PoliTeK/TS741/README.md

<h1 align="center">
	<br>
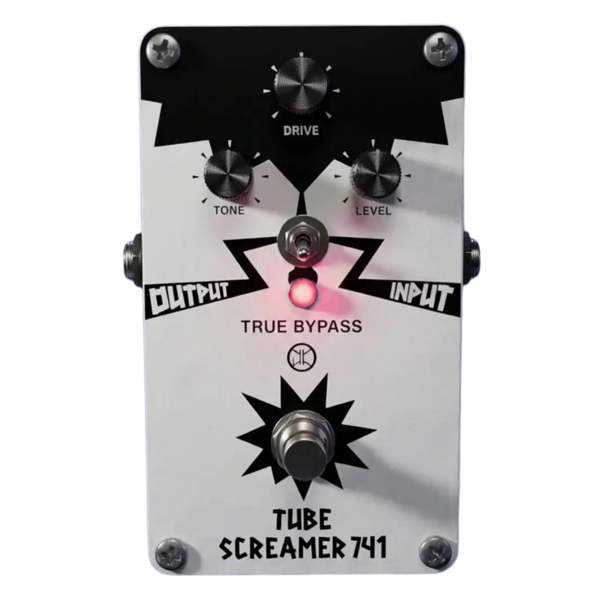
[picture p1: Images/TS741.webp]
		
	<br>
		TS741
	<br>
</h1>

<h4 align="center">A PoliTeK reproduction of the <a href="https://www.ibanez.com/eu/products/detail/ts9_99.html">Ibanez TS9</a>.</h4>

---

> ### 🎉 Big News!
> This project is now fully published! Check out the [Documentation folder](./Documents) for the datasheet, manual and technical documentation.

---

<p align="center">
	<a href="#key-features">Key Features</a> •
	<a href="#list-of-components">List of Components</a> •
	<a href="#how-to-use">How To Use</a> •
	<a href="#credits">Credits</a> •
	<a href="#license">License</a>
</p>

## Key Features

- **2 different clipping modes** using different diodes.
- **More bass mod**: boosted low frequences under 700Hz.
- **Tone mod**: wider frequency response, making the pedal more versatile for other instruments like synths.
- **9V Battery slot**, automatically unplugged when using cable power.
- **True Bypass** to deflect the signal directly from input to output when the effect is disabled.

## List of Components

### Resistors

| Resistor | Characteristics | Link |
| --- | --- | --- |
| $R1$ | $1\ k\Omega$ | [Mouser](https://www.mouser.it/ProductDetail/YAGEO/MFR-25FBF52-1k?qs=oAGoVhmvjhwCAC47ReWjsQ%3D%3D) |
| $R2$ | $510\ k\Omega$ | [Mouser](https://www.mouser.it/ProductDetail/YAGEO/MFR-25FBF52-510k?qs=oAGoVhmvjhztnZ0uHzkmNA%3D%3D) |
| $R3$ | $10\ k\Omega$ | [Mouser](https://www.mouser.it/ProductDetail/YAGEO/MFR-25FBF52-10k?qs=oAGoVhmvjhxY0mVN9GL5Pg%3D%3D) |
| $R4$ | $10\ k\Omega$ | [Mouser](https://www.mouser.it/ProductDetail/YAGEO/MFR-25FBF52-10k?qs=oAGoVhmvjhxY0mVN9GL5Pg%3D%3D) |
| $R5$ | $51\ k\Omega$<br>$100\ k\Omega$ | [Mouser](https://www.mouser.it/ProductDetail/YAGEO/MFR-25FTE52-51k?qs=UFD7vfw3J8rfrZHNaVfLZQ%3D%3D)<br>[Mouser](https://www.mouser.it/ProductDetail/YAGEO/MFR-25FTE52-100k?qs=oAGoVhmvjhwR6%252B9HMeoFJQ%3D%3D) |
| $R6$ | $4.7\ k\Omega$ | [Mouser](https://www.mouser.it/ProductDetail/YAGEO/MFR-12FTF52-4k7?qs=oAGoVhmvjhwCB3QIStJPAg%3D%3D) |
| $R7$ | $1\ k\Omega$ | [Mouser](https://www.mouser.it/ProductDetail/YAGEO/MFR-25FBF52-1k?qs=oAGoVhmvjhwCAC47ReWjsQ%3D%3D) |
| $R8$ | $10\ k\Omega$ | [Mouser](https://www.mouser.it/ProductDetail/YAGEO/MFR-25FBF52-10k?qs=oAGoVhmvjhxY0mVN9GL5Pg%3D%3D) |
| $R9$ | $1\ k\Omega$ | [Mouser](https://www.mouser.it/ProductDetail/YAGEO/MFR-25FBF52-1k?qs=oAGoVhmvjhwCAC47ReWjsQ%3D%3D) |
| $R10$ | $220\ \Omega$<br>$100\ \Omega$  | [Mouser](https://www.mouser.it/ProductDetail/YAGEO/MFR-25FTE52-220R?qs=oAGoVhmvjhzQYrU74Ttjlg%3D%3D)<br>[Mouser](https://www.mouser.it/ProductDetail/YAGEO/MFR-12FTE52-100R?qs=LqRJI78XBD5hLi4WOGMVUQ%3D%3D) |
| $R11$ | $1\ k\Omega$ | [Mouser](https://www.mouser.it/ProductDetail/YAGEO/MFR-25FBF52-1k?qs=oAGoVhmvjhwCAC47ReWjsQ%3D%3D) |
| $R12$ | $510\ k\Omega$ | [Mouser](https://www.mouser.it/ProductDetail/YAGEO/MFR-25FBF52-510k?qs=oAGoVhmvjhztnZ0uHzkmNA%3D%3D) |
| $R13$ | $10\ k\Omega$ | [Mouser](https://www.mouser.it/ProductDetail/YAGEO/MFR-25FBF52-10k?qs=oAGoVhmvjhxY0mVN9GL5Pg%3D%3D) |
| $R14$ | $100\ \Omega$ | [Mouser](https://www.mouser.it/ProductDetail/YAGEO/MFR-12FTE52-100R?qs=LqRJI78XBD5hLi4WOGMVUQ%3D%3D) |
| $R15$ | $10\ k\Omega$ | [Mouser](https://www.mouser.it/ProductDetail/YAGEO/MFR-25FBF52-10k?qs=oAGoVhmvjhxY0mVN9GL5Pg%3D%3D) |
| $R$ | $10\ k\Omega$ | [Mouser](https://www.mouser.it/ProductDetail/YAGEO/MFR-25FBF52-10k?qs=oAGoVhmvjhxY0mVN9GL5Pg%3D%3D) |

### Capacitors

| Capacitor | Characteristics | Link |
| --- | --- | --- |
| $C1$ | $0.02\mu F$ ceramic | [Mouser](https://www.mouser.it/ProductDetail/Vishay-BC-Components/S203M75Z5UN63J0R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) |
| $C2$ | $1\mu F/50V$ film | [Mouser](https://www.mouser.it/ProductDetail/kEMET/R82CC4100AA60J?qs=sGAEpiMZZMsh%252B1woXyUXjwYbDi8EMxhfWJiXWIjZ2PU%3D) |
| $C3$ | $51pF$ MLCC | [Mouser](https://www.mouser.it/ProductDetail/kYOCERA-AVX/SR212A510JARTR1?qs=jADPUJwhBMJOmYc%2FmUo3IA%3D%3D) |
| $C4$ | $0.047\mu F$ ceramic<br>$0.068\mu F$ ceramic | [Mouser](https://www.mouser.it/ProductDetail/kEMET/C320C473k1R5TA?qs=c4UyoTs%2FLq3hm3XzMZbfrg%3D%3D)<br>[Mouser](https://www.mouser.it/ProductDetail/kEMET/C320C683J5R5TA?qs=sGAEpiMZZMsh%252B1woXyUXjwqri5M3Q9AZpanpycjLvCQ%3D) |
| $C5$ | $0.22\mu F/35V$ electrolytic (polarized) | [Digikey](https://www.digikey.it/it/products/detail/panasonic-electronic-components/EEA-GA1HR22/2504589) |
| $C6$ | $0.22\mu F$ electrolytic (polarized) | [Digikey](https://www.digikey.it/it/products/detail/panasonic-electronic-components/EEA-GA1HR22/2504589) |
| $C7$ | $1\mu F/50V$ film | [Mouser](https://www.mouser.it/ProductDetail/kEMET/R82CC4100AA60J?qs=sGAEpiMZZMsh%252B1woXyUXjwYbDi8EMxhfWJiXWIjZ2PU%3D) |
| $C8$ | $0.1\mu F$ ceramic | [Mouser](https://www.mouser.it/ProductDetail/Vishay-BC-Components/k104k15X7RF5TH5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) |
| $C9$ | $10\mu F/16V$ film | [Mouser](https://www.mouser.it/ProductDetail/kEMET/C430C106k3R5TA?qs=QTajy0ParP4Iyid6Jgh%2FcQ%3D%3D) |
| $C10$ | $100\mu F/10V$ electrolytic | [Mouser](https://www.mouser.it/ProductDetail/Vishay-BC-Components/MAL214231101E3?qs=Ep9Lwju7gVq%252BiOgwdeHCkg%3D%3D) |
| $C11$ | $47\mu F/10V$ electrolytic | [Mouser](https://www.mouser.it/ProductDetail/kEMET/ESH476M050AG3kA?qs=gt1LBUVyoHkBFAjlyc6dSw%3D%3D) |

### Diodes

| Diode | Characteristics | Part Number | Link |
| --- | --- | --- | --- |
| $D1$ | Silicon diode | `1N4148` | [Mouser](https://www.mouser.it/ProductDetail/onsemi-Fairchild/1N4148?qs=i4Fj9T%2FoRm8RMUhj5DeFQg%3D%3D) |
| $D2$ | Silicon diode | `1N4148` | [Mouser](https://www.mouser.it/ProductDetail/onsemi-Fairchild/1N4148?qs=i4Fj9T%2FoRm8RMUhj5DeFQg%3D%3D) |
| $D3$<br>$D4$ | Silicon diode<br>Germanium diode<br>LED<br>BJT | `1N4148`<br>`OA95`<br>-<br>- | [Mouser](https://www.mouser.it/ProductDetail/onsemi-Fairchild/1N4148?qs=i4Fj9T%2FoRm8RMUhj5DeFQg%3D%3D)<br>[Pinto Elettronica](https://www.pintoelettronica.com/diodi-ponti-diodo-germanio-oa95.1.0.16.gp.4502.uw)<br>[Mouser](https://www.mouser.it/ProductDetail/Vishay-Siliconix/TLHG6420-CSZ?qs=M%2FWrVUahkW%2Feu6sB%252BQbN0w%3D%3D)<br>[Mouser](https://www.mouser.it/ProductDetail/Rectron/PN2222A-B?qs=wmP56CznGQlBAFU%2Fw%252Bn5vQ%3D%3D) |
| $D$ | Silicon diode | `1N4004` | [Mouser](https://www.mouser.it/ProductDetail/Diotec-Semiconductor/1N4004?qs=OlC7AqGiEDk3eaZusDVIWQ%3D%3D) |

### OP Amp

| OP Amp | Part Number | Link |
| --- | --- | --- |
| $IC1$  | `TL072` | [Mouser](https://www.mouser.it/ProductDetail/Texas-Instruments/TL072CP?qs=5nGYs9Do7G3e6Tx9uHIgUA%3D%3D) |

### Transistors

| Transistor | Part Number | Link |
| --- | --- | --- |
| $Q1$ | `BC550` | [Mouser](https://www.mouser.it/ProductDetail/onsemi-Fairchild/BC550CTA?qs=ljbEvF4DwOM46%2Fg9NzWlqQ%3D%3D) |
| $Q2$ | `BC550` | [Mouser](https://www.mouser.it/ProductDetail/onsemi-Fairchild/BC550CTA?qs=ljbEvF4DwOM46%2Fg9NzWlqQ%3D%3D) |

### Potentiometers

| Potentiometer | Characteristics | Part Number | Link |
| --- | --- | --- | --- |
| Drive | $500\ k\Omega$ logarithmic | `313-1200F-500K` | [Mouser](https://www.mouser.it/ProductDetail/Alpha-Taiwan/RV120F-10-15F-A500K-0075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) |
| Tone | $20\ k\Omega$ linear | `652-PTV09A-4225FB203` | [Mouser](https://www.mouser.it/ProductDetail/Bourns/PTV09A-4225F-B203?qs=Qzws7J6gxqyY5BTaAqzbXg%3D%3D) |
| Level | $100\ k\Omega$ linear | `652-PTV09A-4225FB104` | [Mouser](https://www.mouser.it/ProductDetail/Bourns/PTV09A-4225F-B104?qs=Qzws7J6gxqyxh%252BD4YdlzTg%3D%3D) |

### Connectors and switches

| Component | Link |
| --- | --- |
| Battery Snaps & Contacts | [Mouser](https://www.mouser.it/ProductDetail/Eagle-Plastic-Devices/12BH614A-GR?qs=AUVJHMdIU7wQzMG3L3ucqw%3D%3D) |
| $6.35\ mm$ Audio Jack | [Mouser](https://www.mouser.it/ProductDetail/Same-Sky/MJ-63022B?qs=hWgE7mdIu5QSu1ii218TqA%3D%3D) |
| $2.1\ mm$ DC Barrel Jack | [Mouser](https://www.mouser.it/ProductDetail/Adafruit/373?qs=GURawfaeGuDDC%2FyE6Usrdw%3D%3D) |
| Footswitch | [Mouser](https://www.mouser.it/ProductDetail/Alpha-Taiwan/SF12020F-0202-20R-L-051?qs=8%252Br4Hz5Xir9qUCH0hqBLqw%3D%3D) |
| Switch | [Mouser](https://www.mouser.it/ProductDetail/Soldered/000038?qs=%252BXxaIXUDbq3TSk5iYkYaUg%3D%3D) |

## How To Use

To simulate the behaviour of the PCB we designed, we used LTspice ([download here](https://www.analog.com/en/resources/design-tools-and-calculators/ltspice-simulator.html)).

### LTspice Setup

For the simulation we used an op-amp TL042 model which is not included in LTspice's internal library, so you have to manually import the files `TL072.asy` and `TL072.sub` which you can find inside the `Simulation` folder of this repo.

To find LTspice’s component folder on your computer:
- Open any schematic in LTspice.
- Open the components window pressing the `P` key.
- Under `Top Directory:`, you will see the path to the LTspice's internal library folder:
    - On Windows, it should be something like: `C:\users\<username>\AppData\Local\LTspice\lib\sym`.
    - On Linux:
		- Using Wine, usually the folder is `~/.wine/drive_c/users/<username>/AppData/Local/LTspice/lib/sym`.
		- Without Wine, usually the folder is `~/.local/share/ltspice/drive_c/users/<username>/AppData/Local/LTspice/lib/sym`.
- Move the files:
    - `TL072.asy` to the folder `...\LTspice\lib\sym\OpAmps`.
    - `TL072.sub` to the folder `...\LTspice\lib\sub`.
- After moving the two files, restart LTspice.

### Running a simulation with an external audio

- Inside the `Simulation` folder you can already find a `test.wav` audio file for simulation
- Alternatively, if you want to run a simulation with your own audio file:
    - Convert your audio file to `.wav` format (you can use this [online converter](https://online-audio-converter.com/it/)).
    - Rename your audio file to `test.wav` and place it in the same folder as the simulation file `TS741.asc`.
- Run the simulation and set the duration with the command `.tran <time_in_seconds>`.
- After the simulation, an `output.wav` file will be generated in the same folder as `TS741.asc`, containing the distorted input audio (you can convert it to `.mp3` using the same [online converter](https://online-audio-converter.com/it/)).

### Modifications needed for audio file simulation

To set an audio file as input, set the `value` of the `V2` input generator inside to `WAVEFILE=<filename>.wav` (e.g., `WAVEFILE=test.wav`). To modify the value, press `Ctrl + Right Click` on the `V2` generator.
Spice will search for the file in the same folder as `TS741.asc`.
To generate an output file, use the command `.wave <filename>.wav 16 44.1k V(<output_node>)` (for more details on this command, check [this link](https://spiceman.net/ltspice-command-wave/#index_id1)).

### Troubleshooting for `Bad wave file format found in test.wav` error

Check [this Reddit thread](https://www.reddit.com/r/diypedals/comments/oozekw/ltspice_wav_file_input/).

### Simulating potentiometers inside LTspice

A linear potentiometer can be represented in SPICE using two resistors, `Tone1` and `Tone2`, with values of $m * R_{max}$ and $(1 - m) * R_{max}$, where:
- $R_{max}$ is the potentiometer’s maximum resistance.
- $m$ is a parameter ranging from $0$ to $1$ that indicates the potentiometer’s position.

To set these values in the `Tone1` and `Tone2` resistors, press `Ctrl + Right Click` on the resistor and enter the formula in curly brackets.

The `.param` command allows you to define a parameter value:

```
.param <parameter_name> = <parameter_value>
```

A logarithmic potentiometer is represented by two resistors with values $R_{tot} * (1 - m^k)$ and $R_{tot} * m^k$.

> Note: the exponentiation operator in LTspice is `**`, not `^`.

To run a simulation that varies a parameter and observe its effect on circuit quantities ($V$ and $I$), use the `.step` param command:

```
.step param <parameter_name> <min_value> <max_value> <increment>
```

### About the minimum resistance $R_{min}$

Ideally, the parameter $m$ should vary from $0$ (fully closed potentiometer) to $1$ (fully open potentiometer), but LTspice does not accept zero resistance values. This causes an error when calculating $R$ for $m = 0$ and $m = 1$. To avoid this, a very small $R_{min}$ (`1m`, i.e., $10^{-3}$) is added to the resistance values.

## Credits

For this project, we used the [Tube Screamer Analysis made by Electrosmash](https://electrosmash.com/tube-screamer-analysis).

## License

[MIT](https://choosealicense.com/licenses/mit/)

---

<p align="center">
	<a href="mailto:info.politek23@gmail.com">E-Mail</a> •
	<a href="https://www.instagram.com/politek_music">Instagram</a> •
	<a href="https://t.me/+dLKMAwzNmQYxNzM0">Telegram Community</a>
</p>
