PoliTeK/TS741/Documentation/Circuit2TikZ Designer/README.md

In this subfolder you can find the JSON files of the circuits that you can load on https://www.circuit2tikz.tf.fau.de/designer/ to modify the design of the circuits and generate new CircuiTikZ code.

The `complete.json` file contains the JSON code for the complete circuit.
