PoliTeK/TS741/Images/PCB_front.png

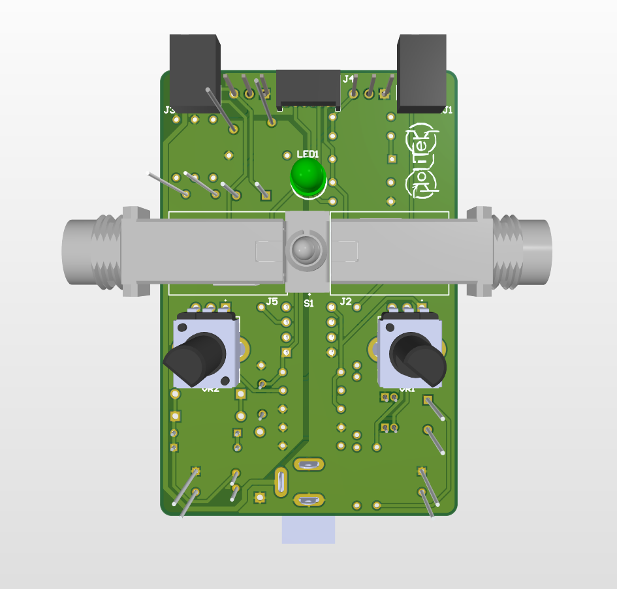
Images/PCB_front.png
