PoliTeK/TS741/Images/PCB_retro.png

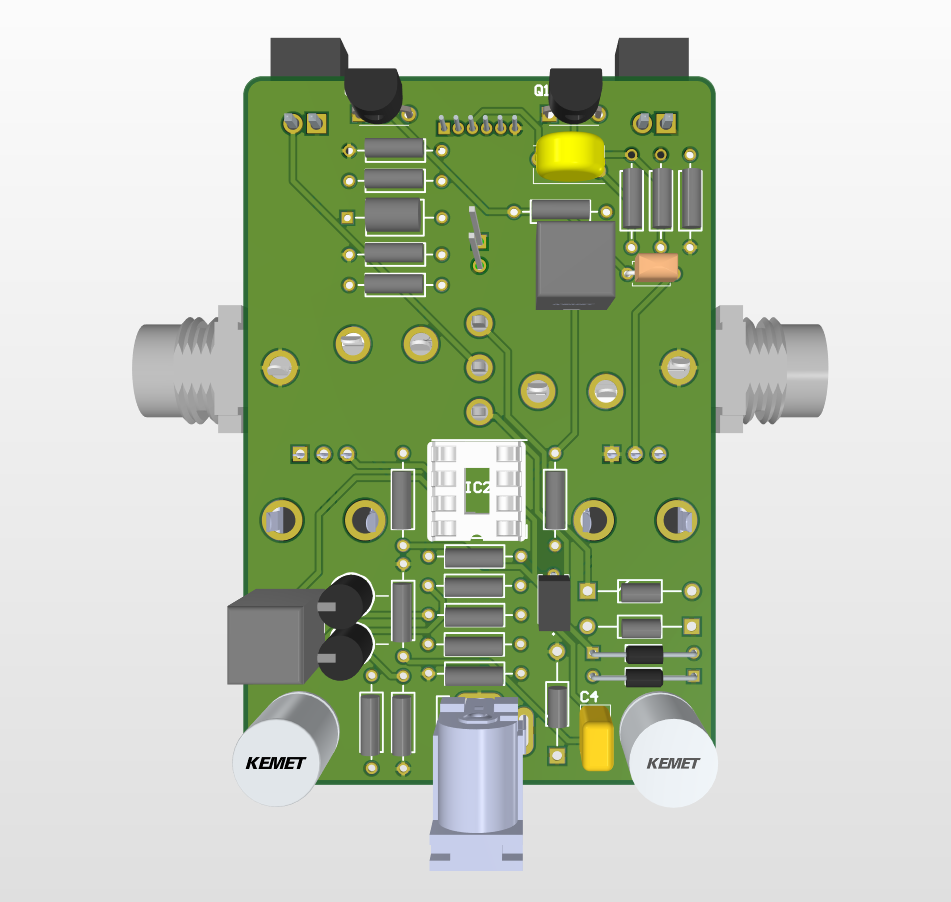
Images/PCB_retro.png
