PoliTeK/TS741/PCB/PCB_bottom.png

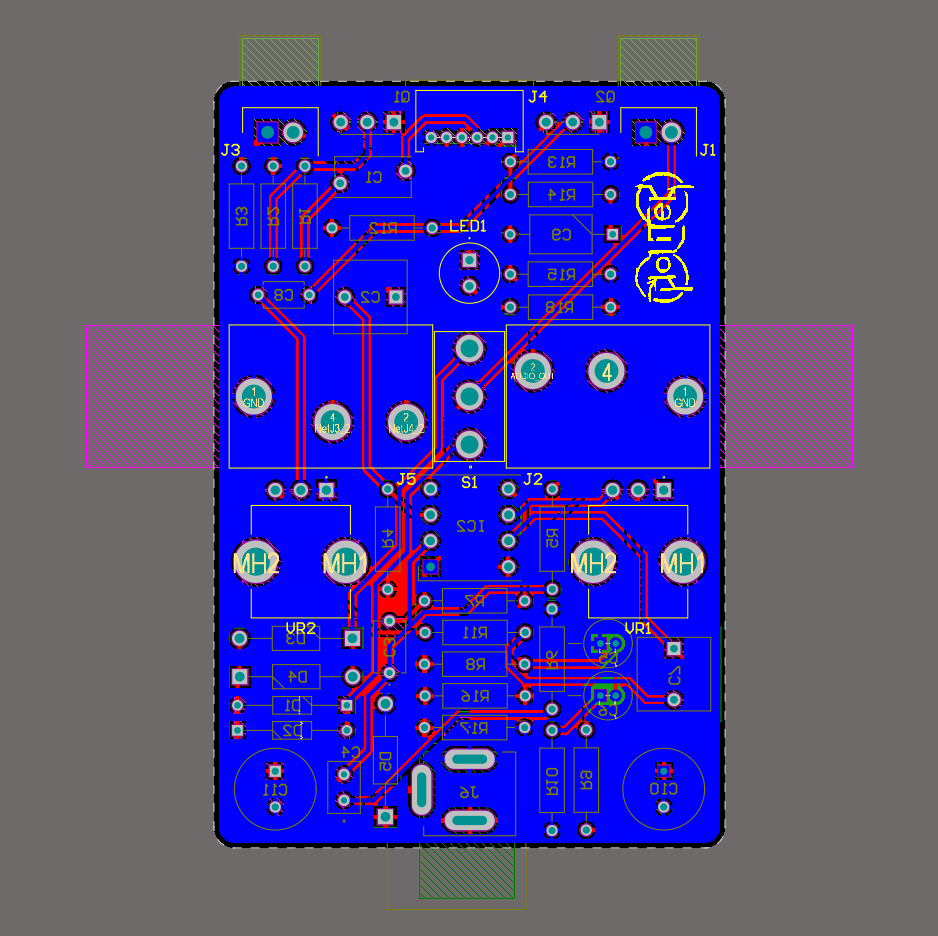
PCB/PCB_bottom.png
