PoliTeK/TS741/PCB/PCB_top.png

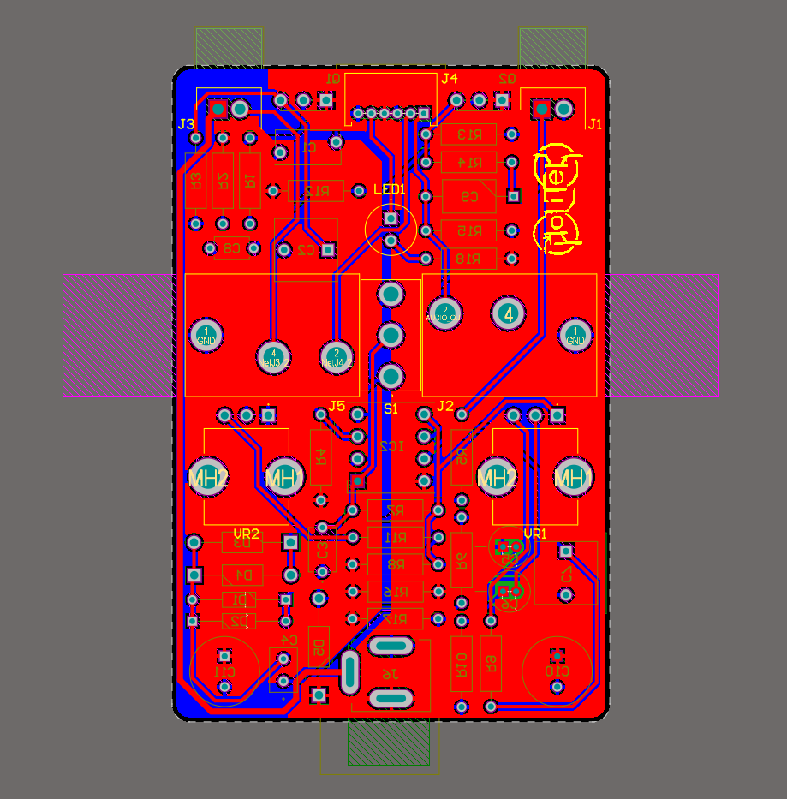
PCB/PCB_top.png
