PoliTeK/TS741/Simulation/grafici simulazioni spice/analisi_freq_variando_level.JPG

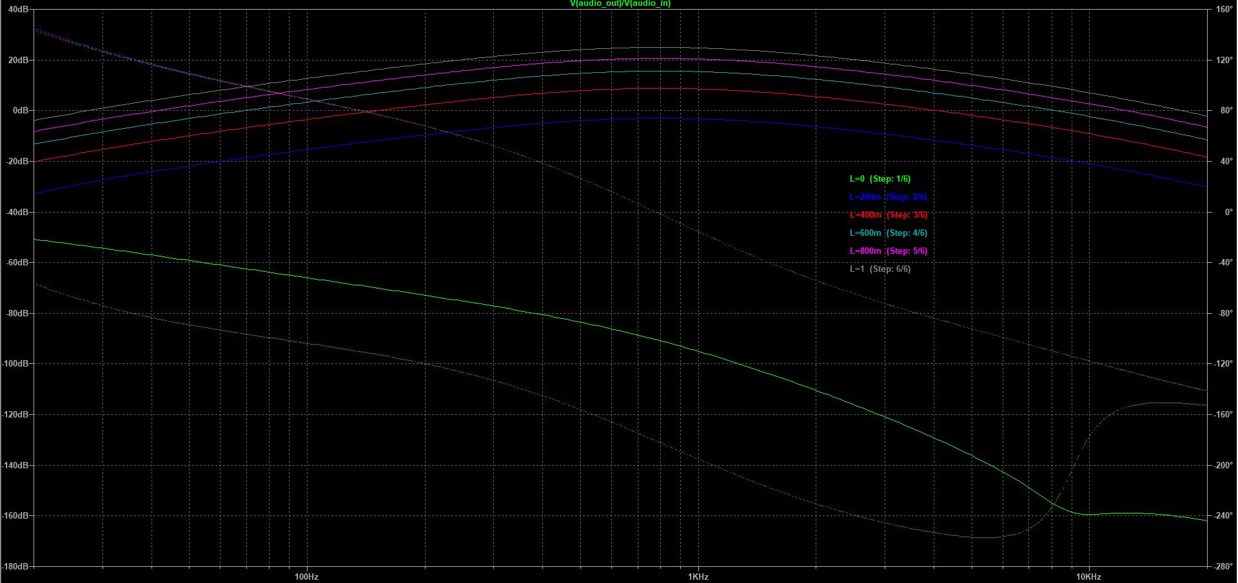
Simulation/grafici simulazioni spice/analisi_freq_variando_level.JPG
