PoliTeK/TS741/Simulation/grafici simulazioni spice/analisi_freq_variando_TONE.JPG

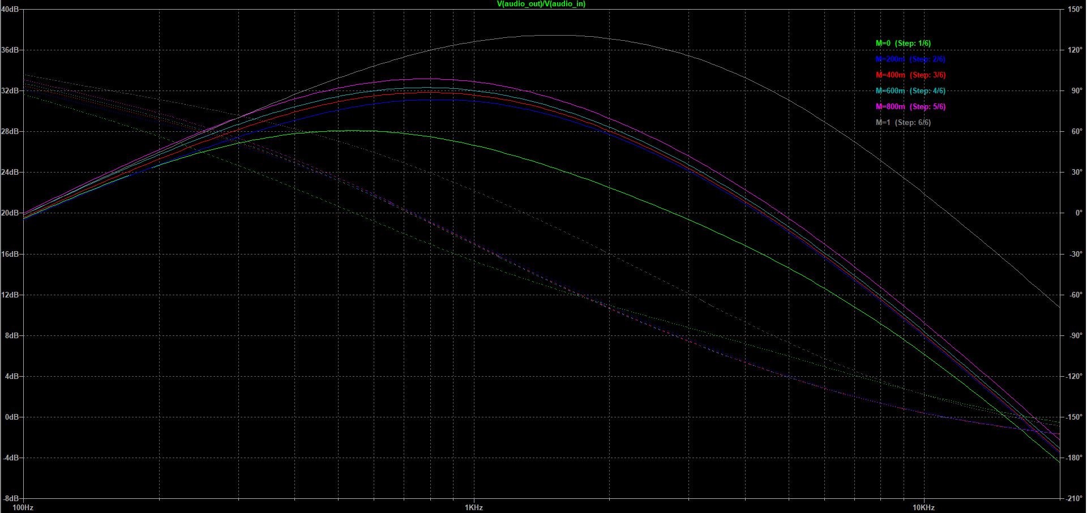
Simulation/grafici simulazioni spice/analisi_freq_variando_TONE.JPG
