PoliTeK/TS741/Simulation/grafici simulazioni spice/Vout_al_variare_del_tone.JPG

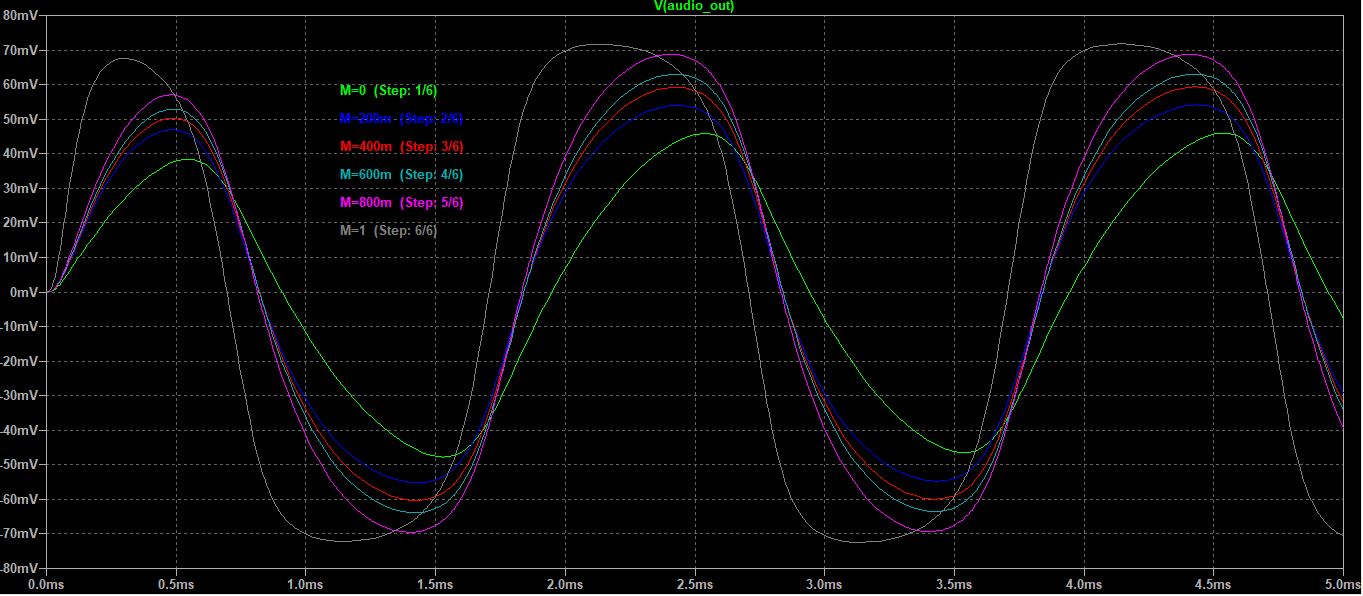
Simulation/grafici simulazioni spice/Vout_al_variare_del_tone.JPG
