PoliTeK/TS741/Simulation/grafici simulazioni spice/Vout_al_variare_di_level.JPG

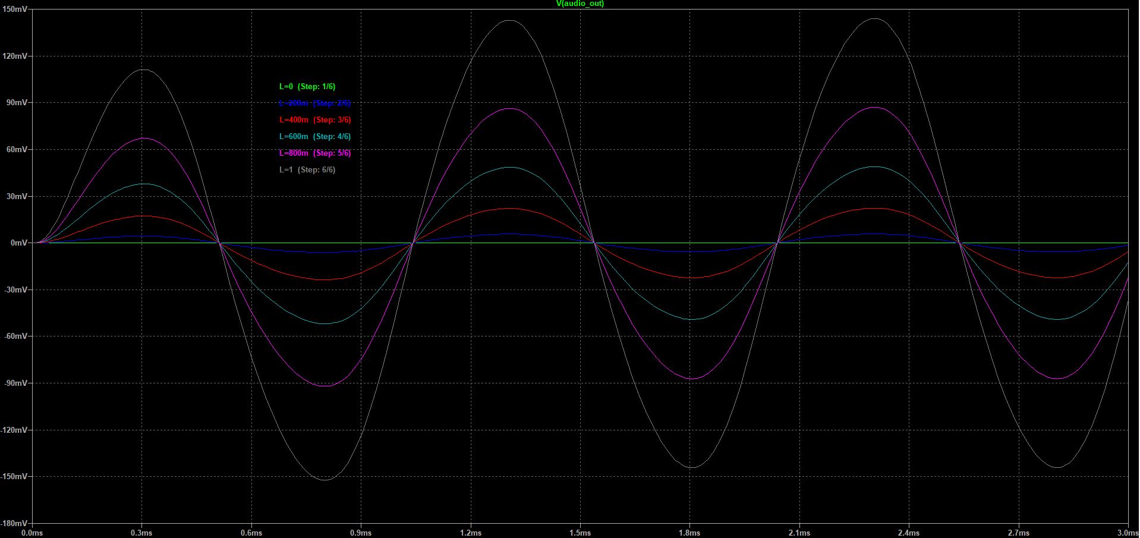
Simulation/grafici simulazioni spice/Vout_al_variare_di_level.JPG
