PoliTeK/TS741/Case 3D/3D Print Files/STL/DOOR.stl

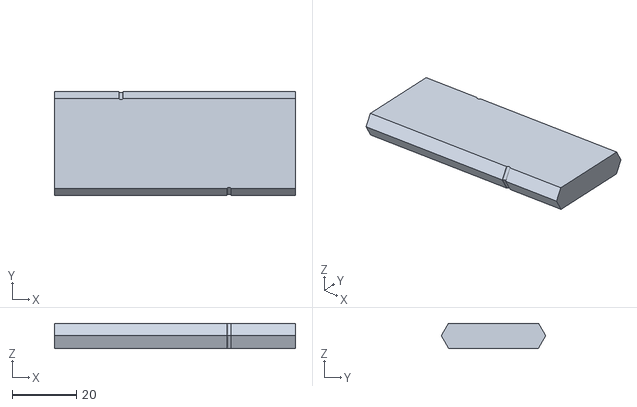
[picture p27: CAD file, 2026-05-05]
Case 3D/3D Print Files/STL/DOOR.stl
75.0 x 32.5 x 7.80
