PoliTeK/TS741/Case 3D/Rhino Project/3MF/FRONT.3mf

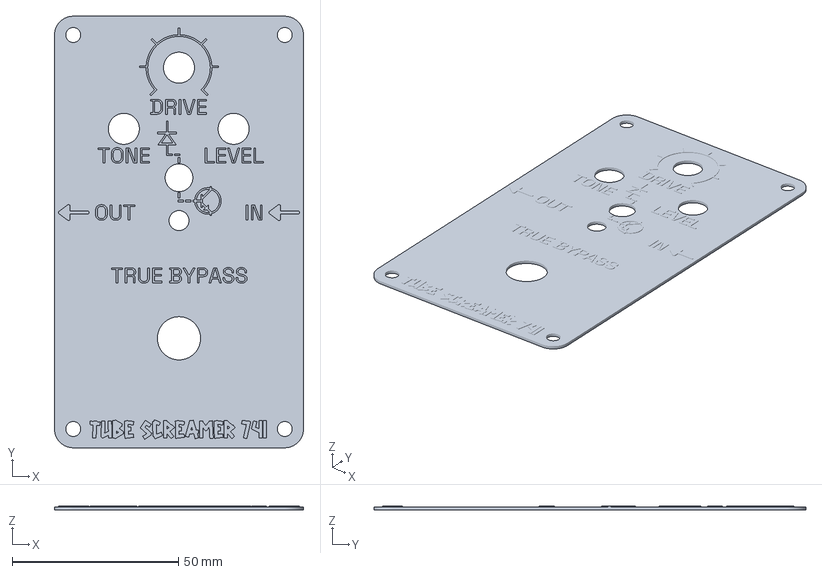
[picture p28: CAD file, 2026-05-05]
Case 3D/Rhino Project/3MF/FRONT.3mf
75.0 x 130.0 x 1.32 mm
