PoliTeK/TS741/Front Panel/Alluminium Laser Marking/TS741.stp

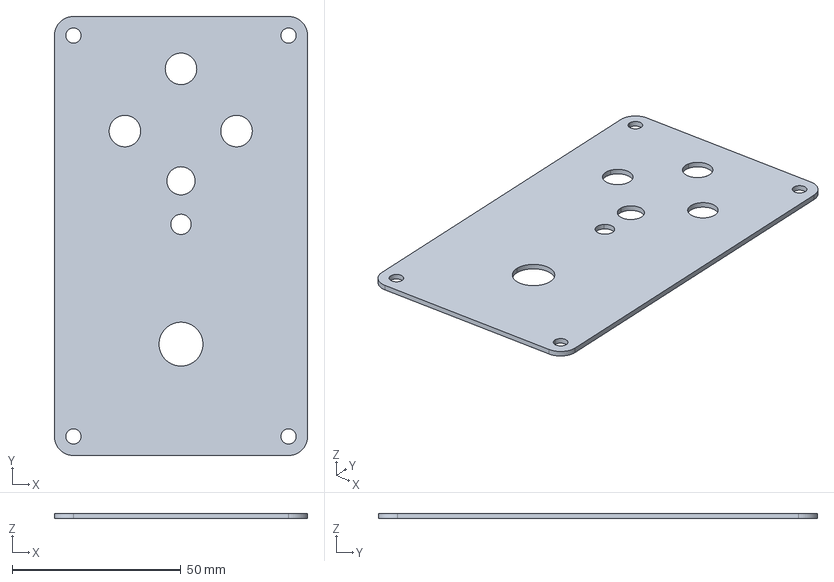
[picture p29: CAD file, 2026-05-28]
Front Panel/Alluminium Laser Marking/TS741.stp
75.0 x 130.0 x 1.60 mm
