PoliTeK/TS741/Case 3D/3D Print Files/STL/UP.stl

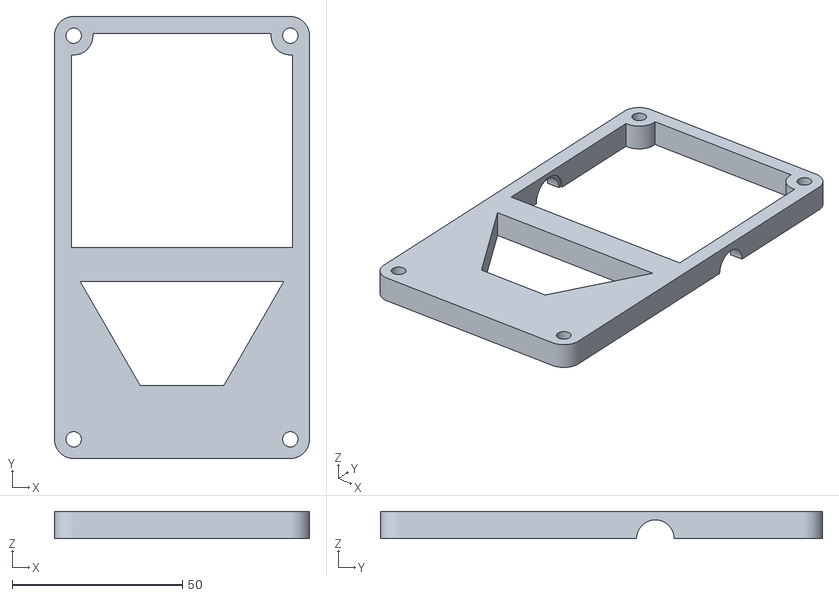
[picture p30: CAD file, 2026-05-05]
Case 3D/3D Print Files/STL/UP.stl
75.0 x 130.0 x 7.99
