PoliTeK/TS741/Case 3D/Rhino Project/3MF/DOWN.3mf

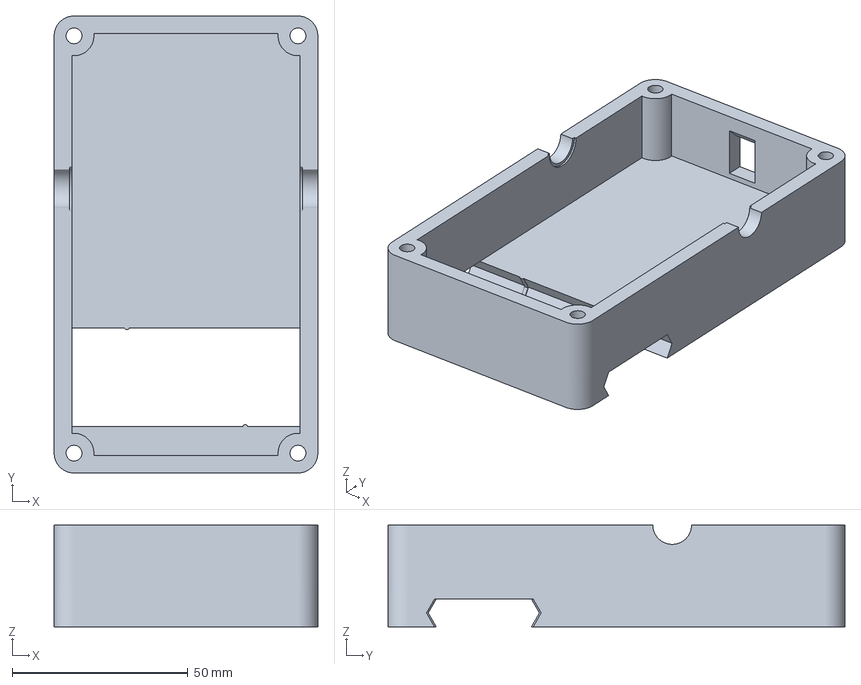
[picture p31: CAD file, 2026-05-05]
Case 3D/Rhino Project/3MF/DOWN.3mf
75.0 x 130.0 x 29.0 mm
