PoliTeK/TS741/(list of files, cad)

Other CAD files:
Front Panel/3D/FRONT.stl
Case 3D/Rhino Project/3MF/DOOR.3mf
Case 3D/Rhino Project/3MF/UP.3mf
Front Panel/Alluminium Laser Marking/TS741.dxf
