PoliTeK/TS741/PCB/Schematics_TS741.pdf

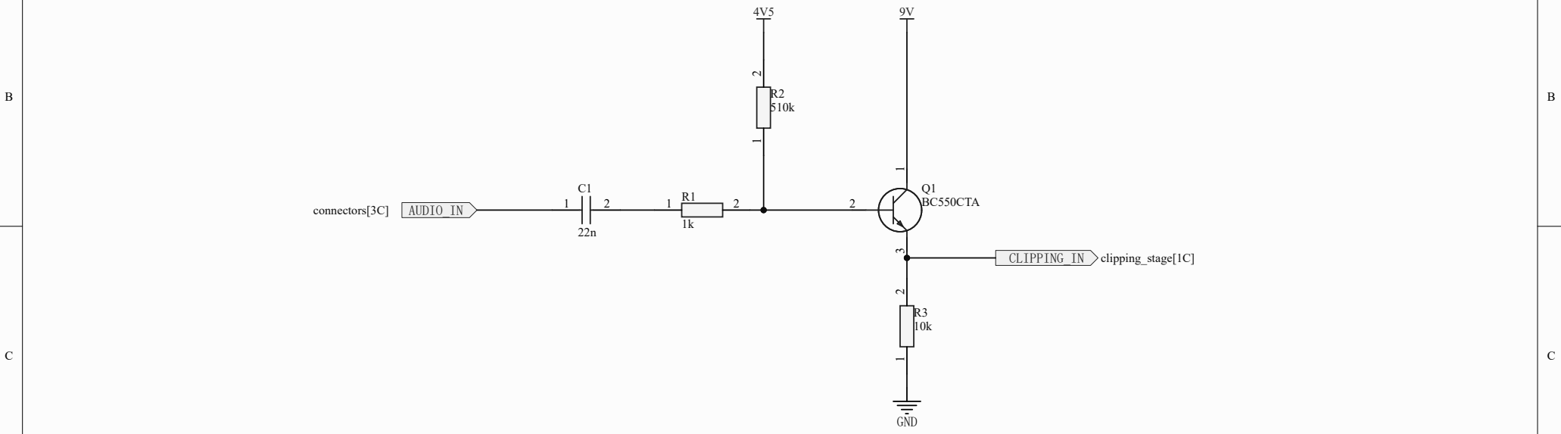
[picture p32: figure]
connectors[3C]; AUDIO_IN; GND; CLIPPING_IN; clipping_stage[1C]; Q1 BC550CTA

1

2

3

4

D D

A A

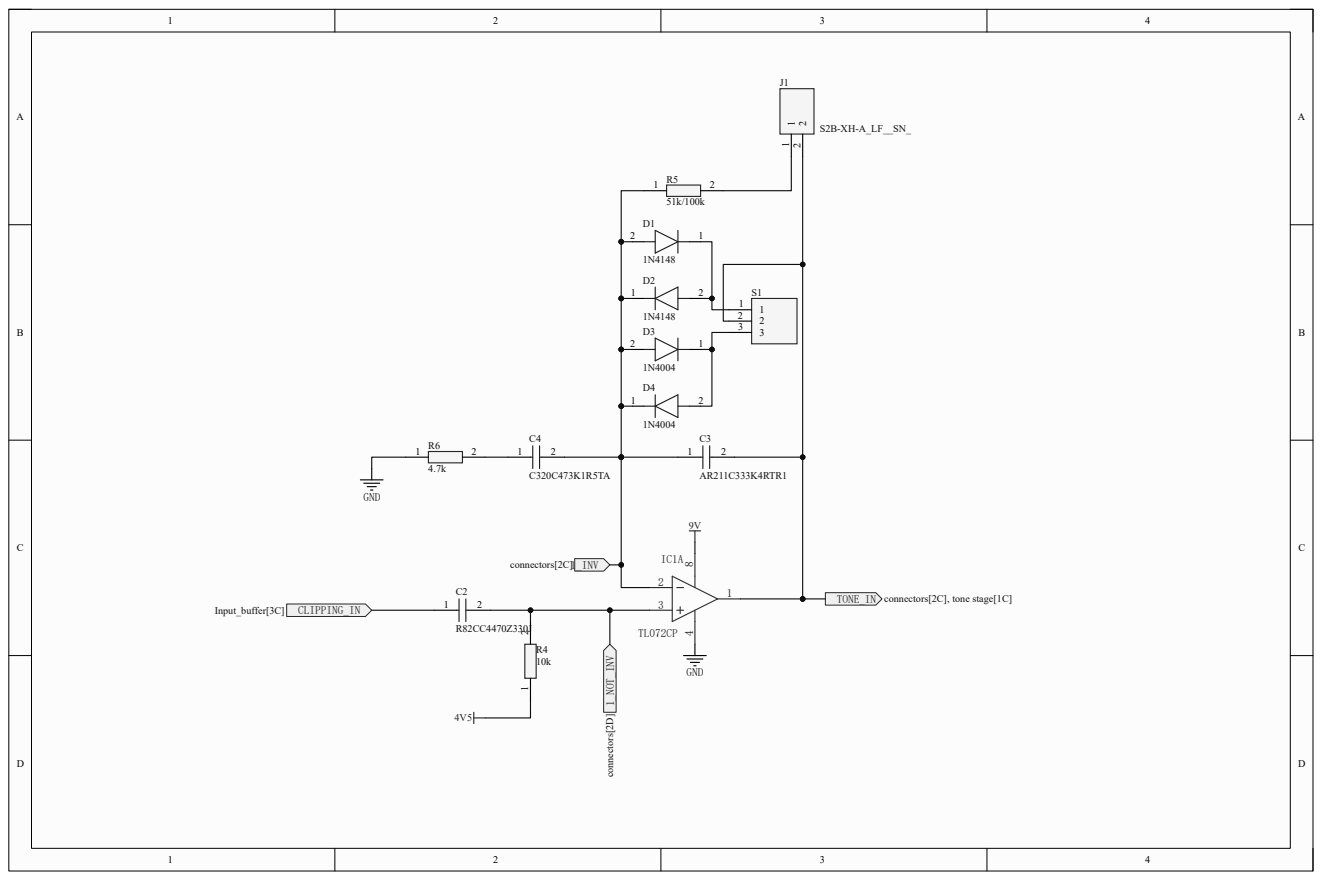
[picture p33: page 2]

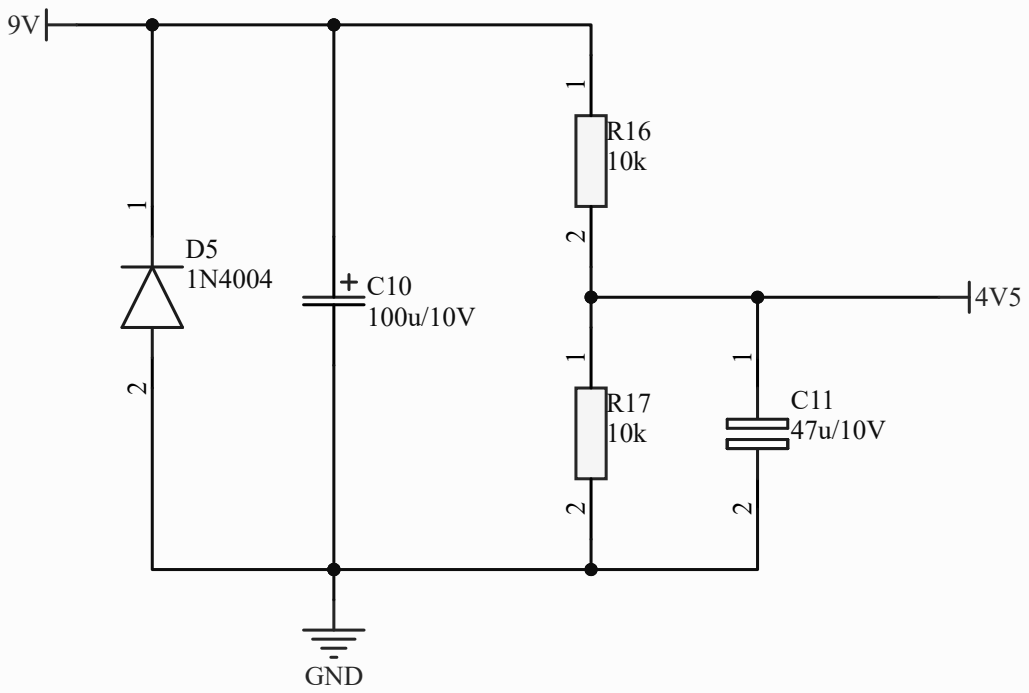
[picture p34: page 3]
GND

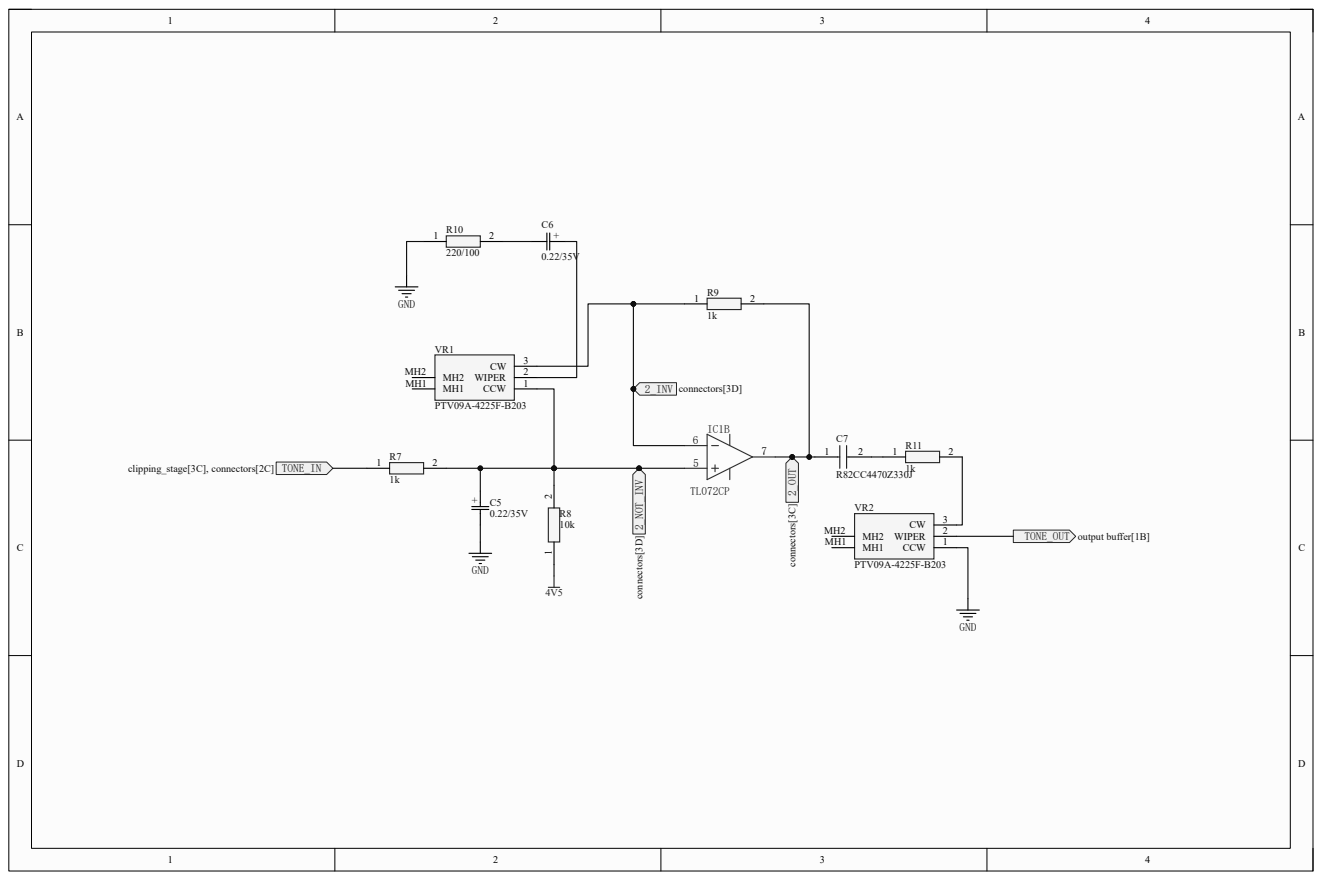
[picture p35: page 4]

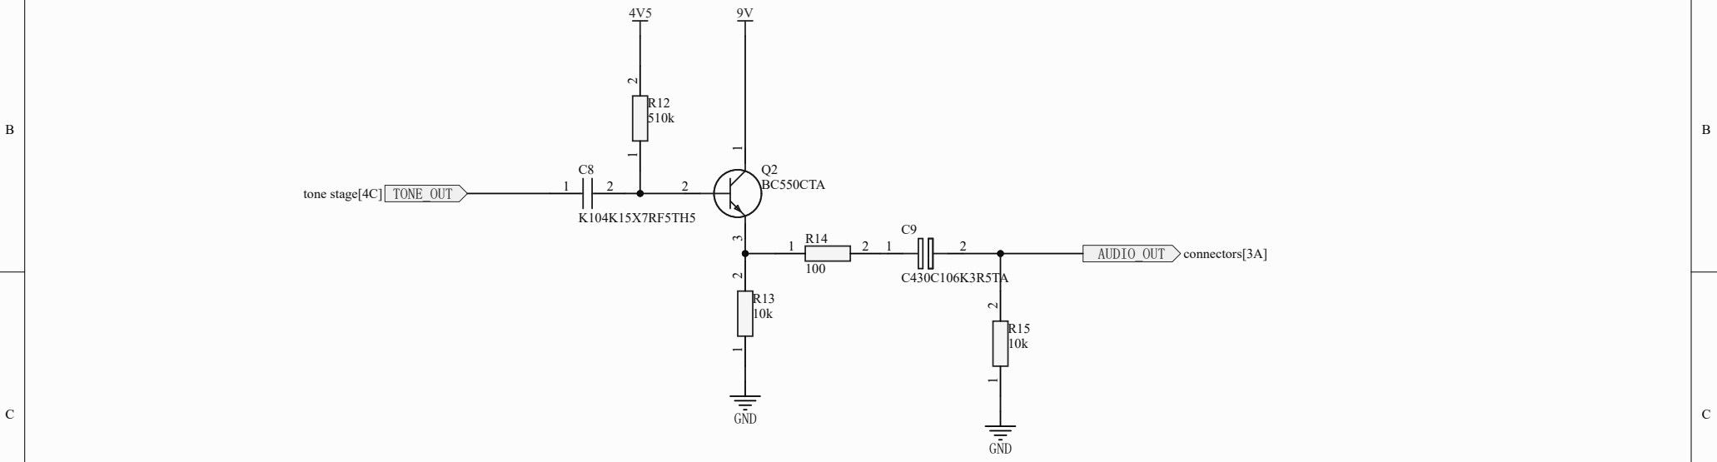
[picture p36: figure]
tone stage[4C] TONE_OUT; GND; AUDIO_OUT; connectors[3A] ¹ ²; Q2 BC550CTA

D D

A A

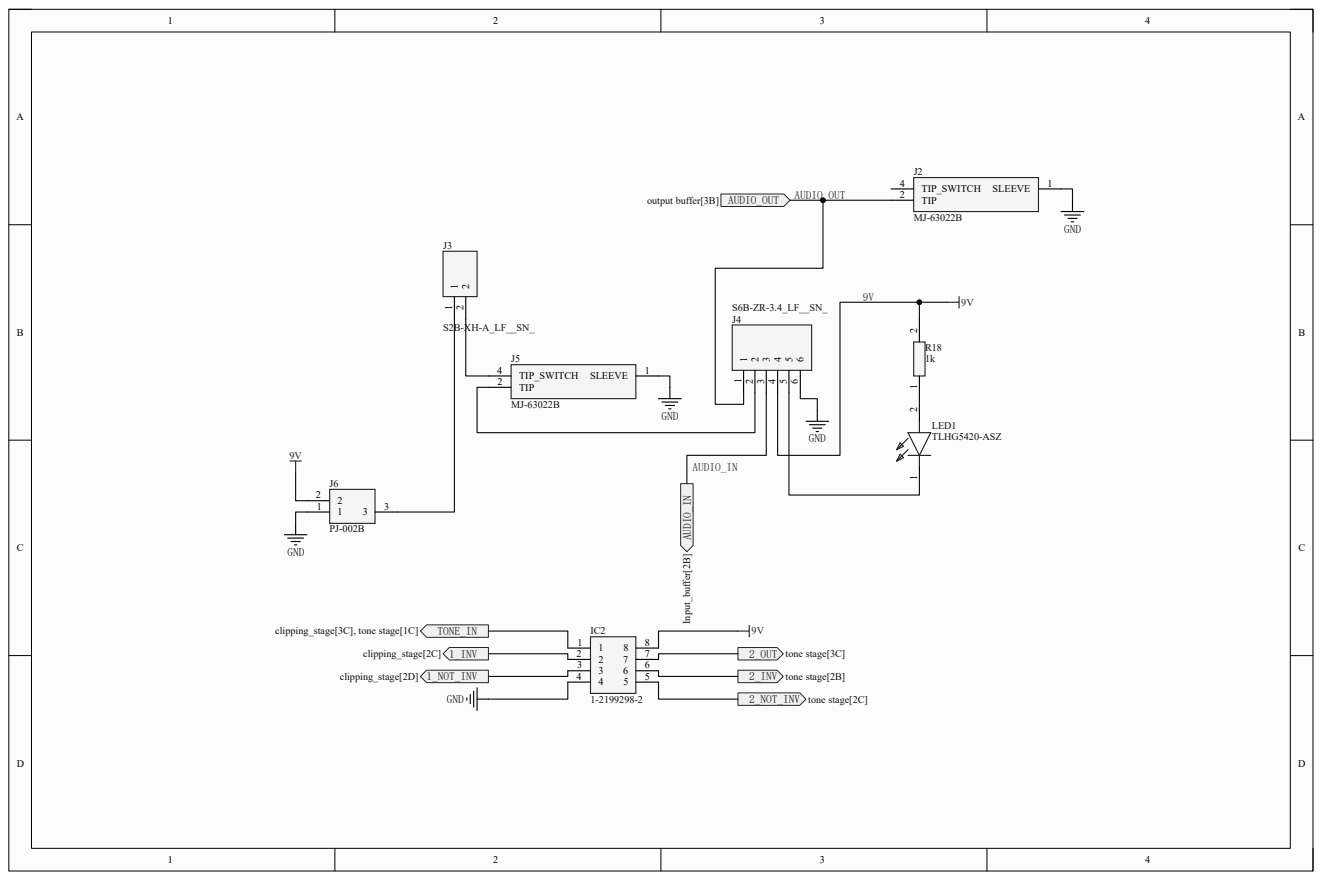
[picture p37: page 6]
