PoliTeK/TS741/PCB/PCB_TS741.pdf

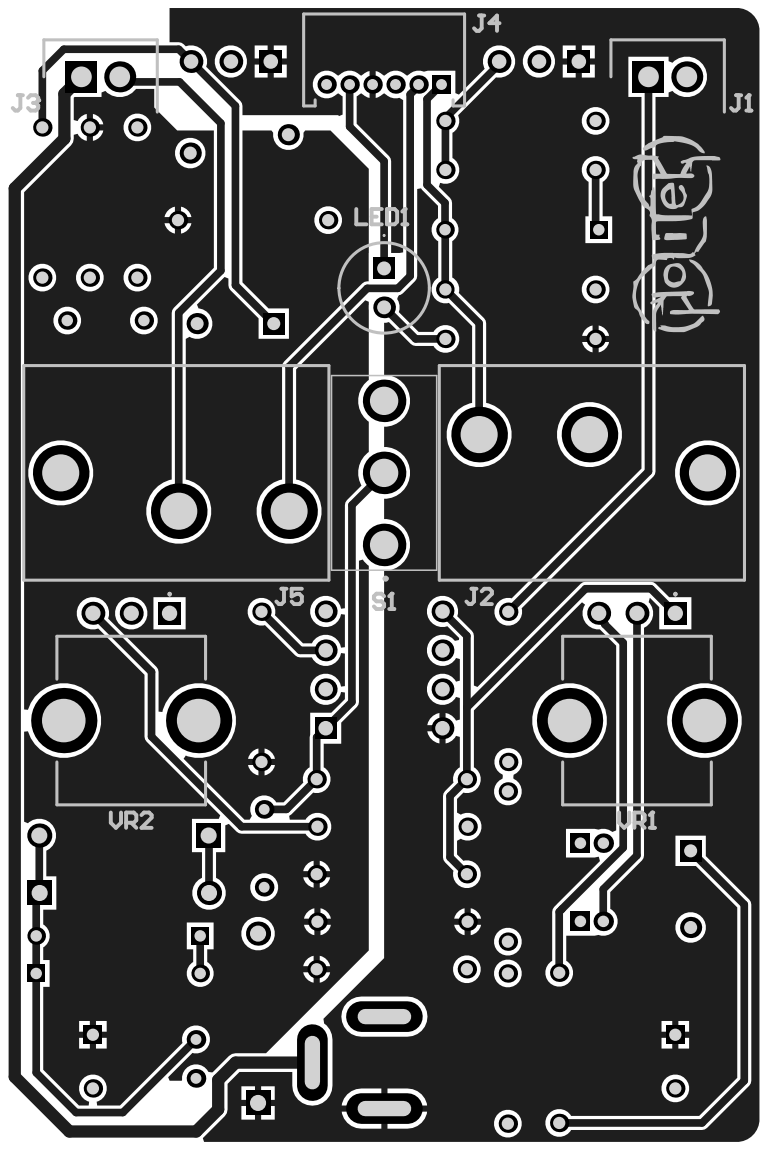
[picture p38: page 1]

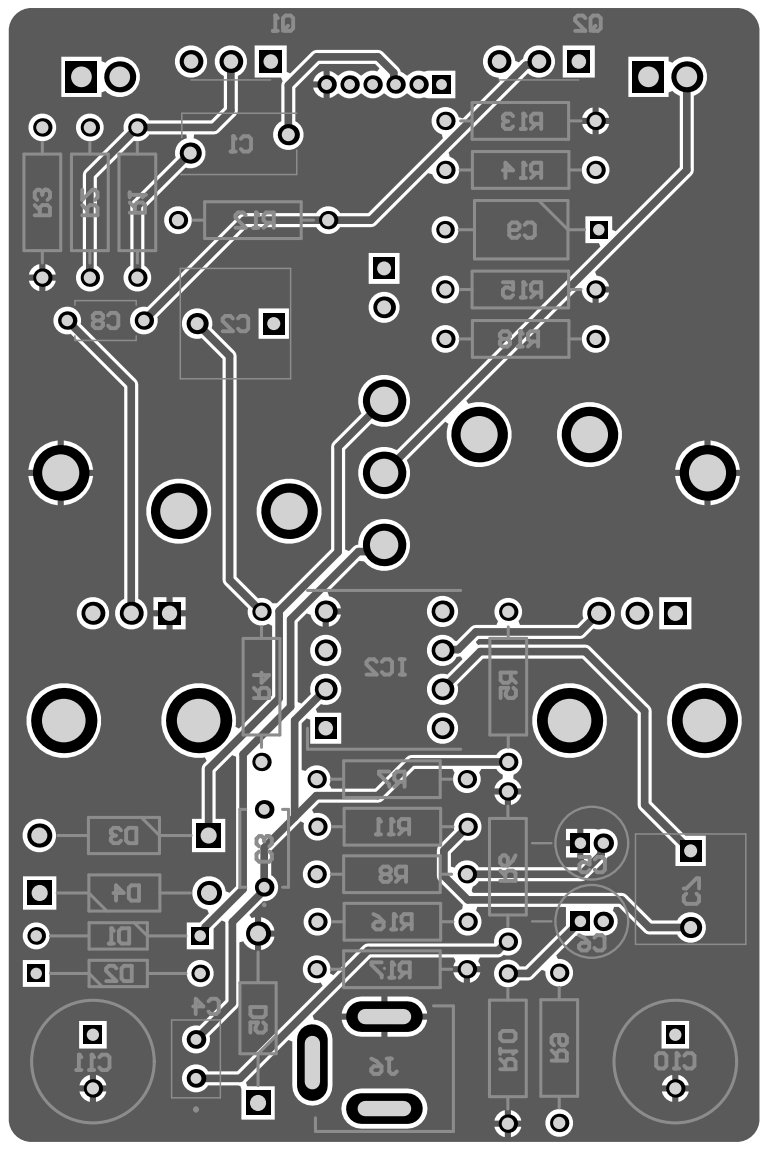
[picture p39: page 2]
