PoliTeK/TS741/Simulation/TS741.asc

C1: cap; 0.02µ
C2: cap; 1µ; V=50
C3: cap; 0.047µ
C4: cap; 51p
C5: polcap; 0.22µ; V=35
C6: polcap; 0.22µ; V=35
C7: cap; 1µ; V=50
C8: cap; 0.1µ
C9: cap; 10µ; V=16
C16: cap; 47µ; V=10
C17: cap; 100µ; V=10
D1: diode; 1N4148
D2: diode; 1N4148
D8: diode; 1N4148
Drive: res; {R_min + R_drive * ( n**k)}
Level1: res; {R_min + R_level * ( 1 - l**k)}
Level2: res; {R_min + R_level * ( l**c)}
Q1: npn; 2SC2412K
Q3: npn; 2SC2412K
R1: res; 1k
R2: res; 510k
R3: res; 10k
R4: res; 4.7k
R5: res; 10k
R6: res; 51k
R8: res; 1k
R9: res; 10k
R11: res; 1k
R12: res; 1k
R13: res; 510k
R14: res; 10k
R15: res; 220
R32: res; 10k
R33: res; 10k
RB: res; 100
RC: res; 10k
Tone1: res; {R_min + R_tone*m}
Tone2: res; {R_min + (1 - m)*R_tone}
U3: TL072
U4: TL072
V1: battery; 9
V2: signal; AC 1
Named nets: 0, 9V, 4V5, Audio_Out, Audio_In
INPUT BUFFER
CLIPPING STAGE
TONE/VOLUME STAGE
OUTPUT BUFFER
POWER SUPPLY
INPUT SIGNAL
SIMULATION
.param R_tone = 20k
.param R_drive = 500k
.param k = 2
.step param l 0 1 0.2
.param m = 0.5
.param R_min = 1m
.param R_level = 100k
.param c = 2
.param n = 0.5
.ac dec 100 20 20k
