PoliTeK/TS741/(commit log)

2024-10-20 Update pedale_non_finito.asc
    completato lo schematico, aggiunte resistenze per simulare i potenziometri.
    TO DO:
    - Cambiare modelli di opamp e transistor
    - Trovare parametri ottimali per simulazione
2024-12-06 Add files via upload
    creazione di una cartella per i file generati dal programma spice
2025-01-16 aggiunti componenti PCB
    [1-2199298-2.SchLib, 1-2199298-2.stp, 1N4004.SchLib, 1N4004.stp, 1N4148.SchLib, 1N4148.stp, AR211C333K4RTR1.PcbLib, AR211C333K4RTR1.SchLib]
2026-03-05 aggiunti gerber, foto, riorganizzato il repo
    [1-2199298-2.SchLib, 1-2199298-2.stp, 1N4004.SchLib, 1N4004.stp, 1N4148.SchLib, 1N4148.stp, AR211C333K4RTR1.PcbLib, AR211C333K4RTR1.SchLib]
2026-04-28 cancellati documenti di prova
2026-05-05 aggiunto datasheet e file di stampa, aggiornato il render
    [DOOR.3mf, DOOR.stl, DOWN.3mf, FRONT.3mf, FRONT.stl, UP.3mf, UP.stl]
2026-05-16 feat: add JSON files for Circuit2TikZ Designer
2026-05-21 fix: fix resistor name from R6 to R5
2026-05-28 aggiornati frontpanel
    [DOOR.3mf, DOWN.3mf, FRONT.3mf, FRONT.stl, TS741.dxf, TS741.stp, UP.3mf]
2026-06-01 aggiunta cartella sample
2026-06-01 sample convertiti in mp3
